arjun-mec/RFEH-Backscatter-FYP/Simulations/#3 Harvester Transients/harvester transient.png

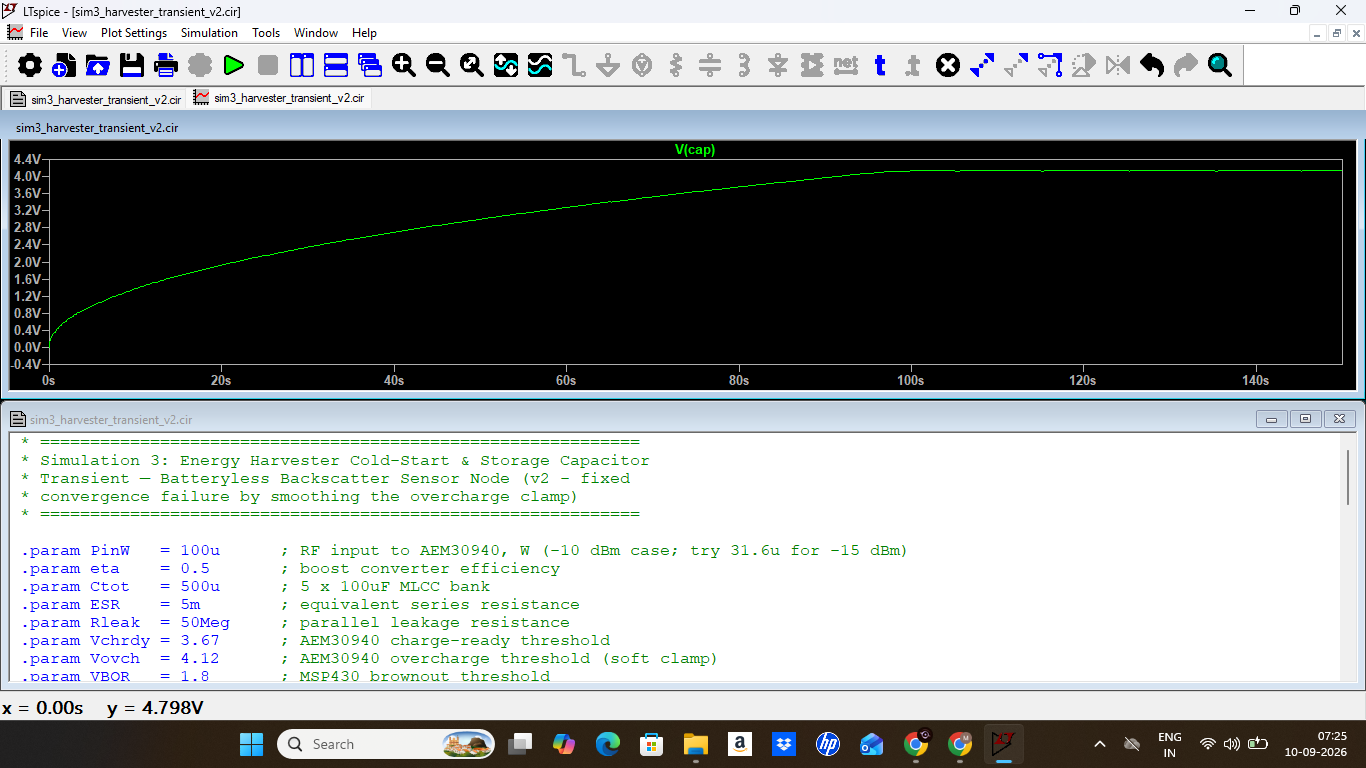
Simulations/#3 Harvester Transients/harvester transient.png
