arjun-mec/RFEH-Backscatter-FYP/Simulations/#6 3D Dual-Polarized Antenna Far-Field & Direct Leakage Isolation Simulation/Bistatic_Topology_CAD_Model.png

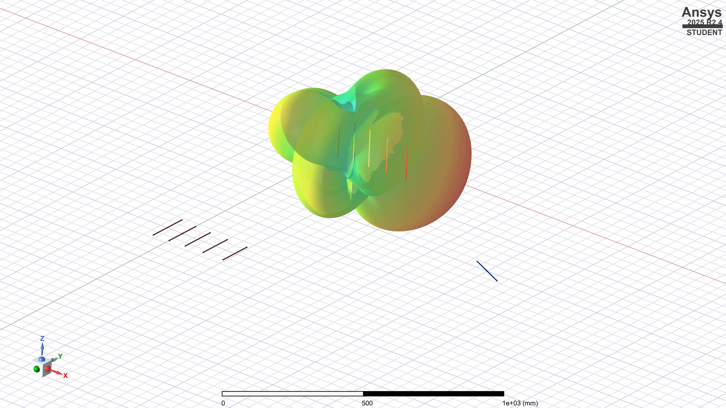
Simulations/#6 3D Dual-Polarized Antenna Far-Field & Direct Leakage Isolation Simulation/Bistatic_Topology_CAD_Model.png
