arjun-mec/RFEH-Backscatter-FYP/Simulations/#6 3D Dual-Polarized Antenna Far-Field & Direct Leakage Isolation Simulation/Tx_Azimuth_Cut_HPlane.png

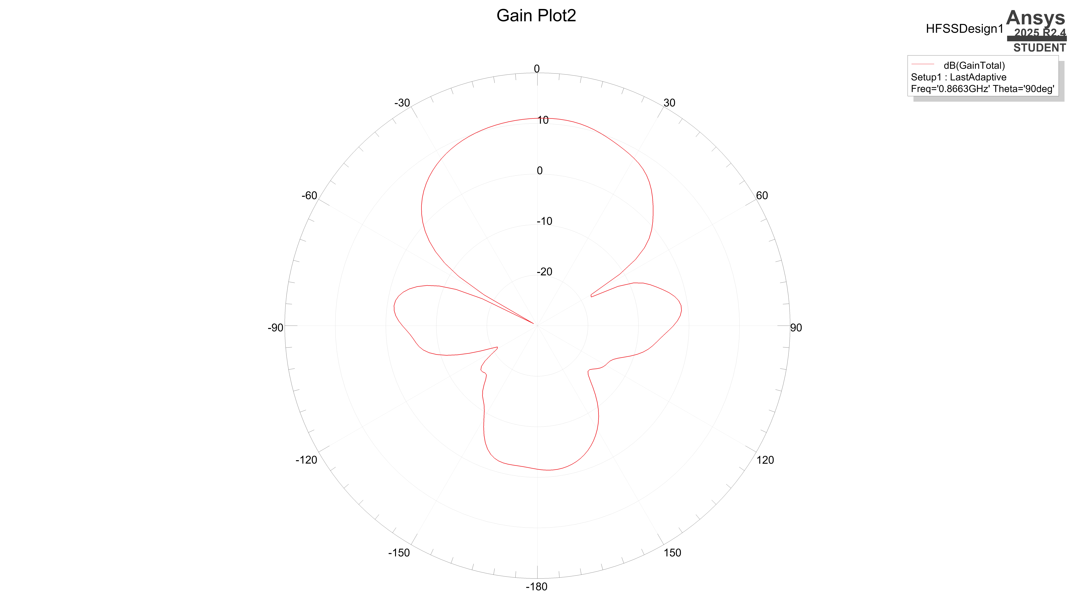
Simulations/#6 3D Dual-Polarized Antenna Far-Field & Direct Leakage Isolation Simulation/Tx_Azimuth_Cut_HPlane.png
