arjun-mec/RFEH-Backscatter-FYP/Simulations/#6 3D Dual-Polarized Antenna Far-Field & Direct Leakage Isolation Simulation/Tx_Elevation_Cut_EPlane.png

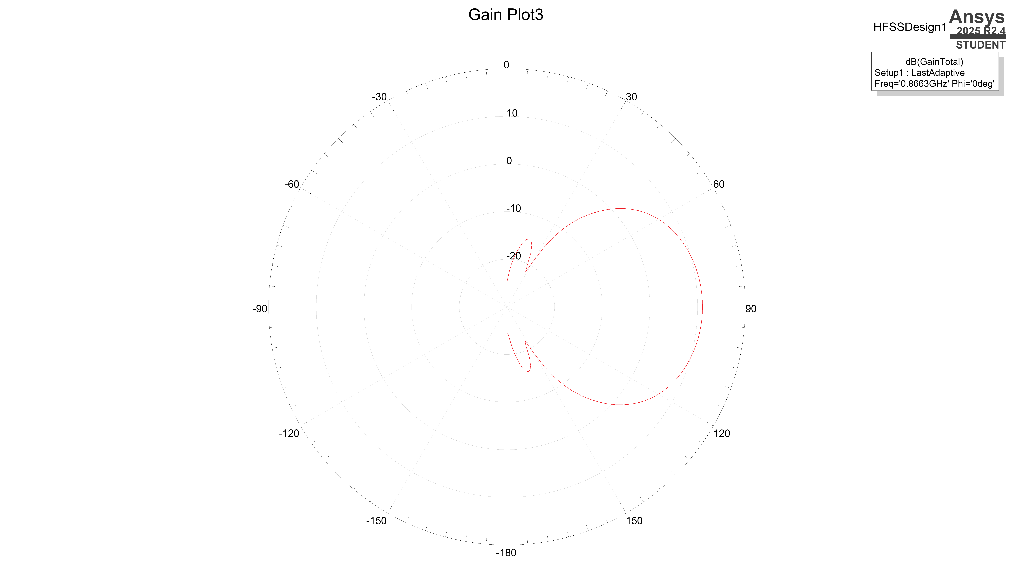
Simulations/#6 3D Dual-Polarized Antenna Far-Field & Direct Leakage Isolation Simulation/Tx_Elevation_Cut_EPlane.png
