arjun-mec/RFEH-Backscatter-FYP/Simulations/#6 3D Dual-Polarized Antenna Far-Field & Direct Leakage Isolation Simulation/Tx_FarField_3D_Gain.png

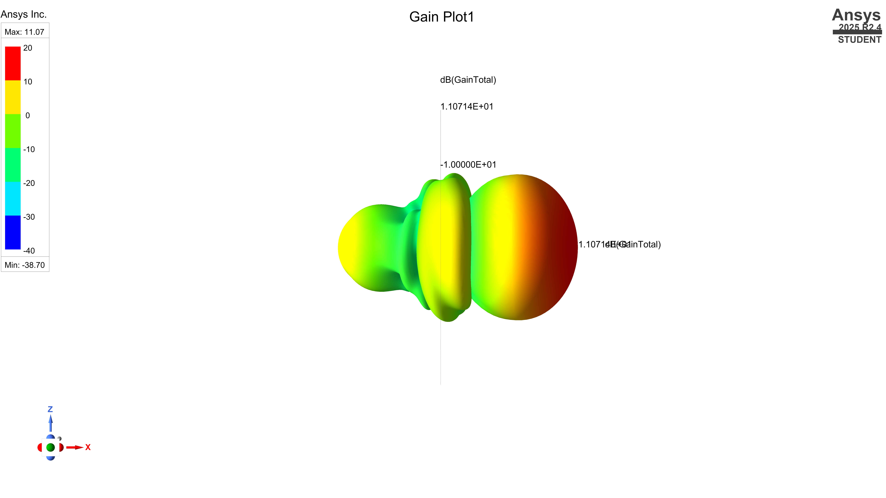
Simulations/#6 3D Dual-Polarized Antenna Far-Field & Direct Leakage Isolation Simulation/Tx_FarField_3D_Gain.png
